schuyler4/LCR_Meter/readme.md

<h3> LCR Meter </h3>
<p>
 This is my attempt at making an LCR meter. It is still in progress, but here is a schematic if you are interested.
</p>
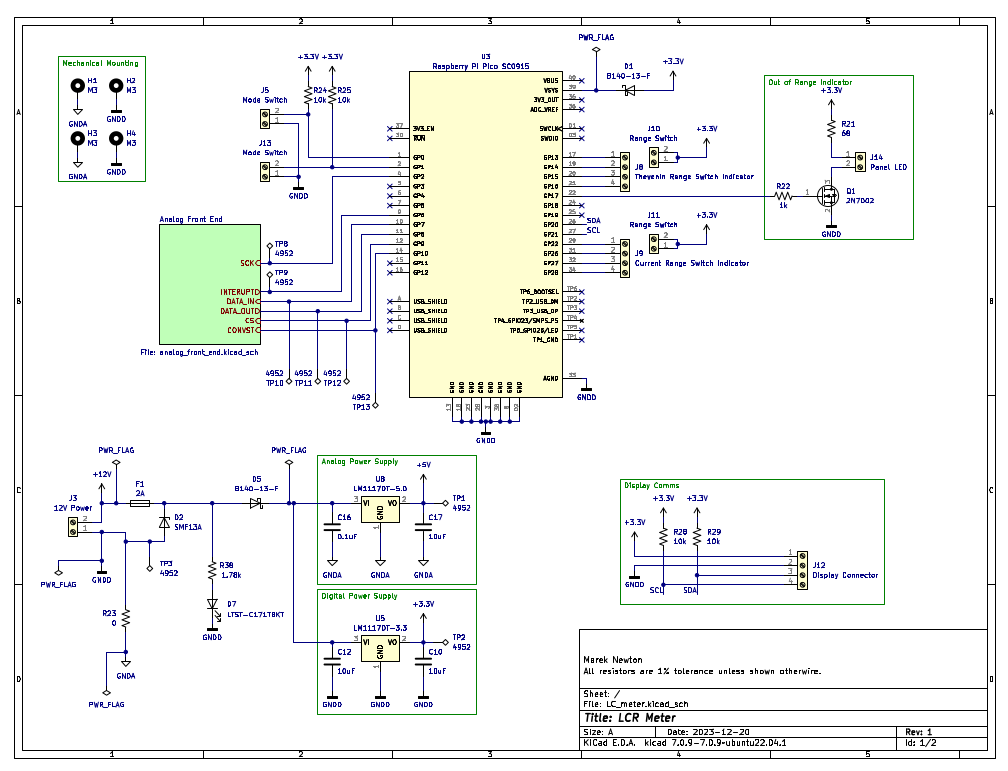
[picture p1: electronics/rev1/outputs/page1_schematic.png]

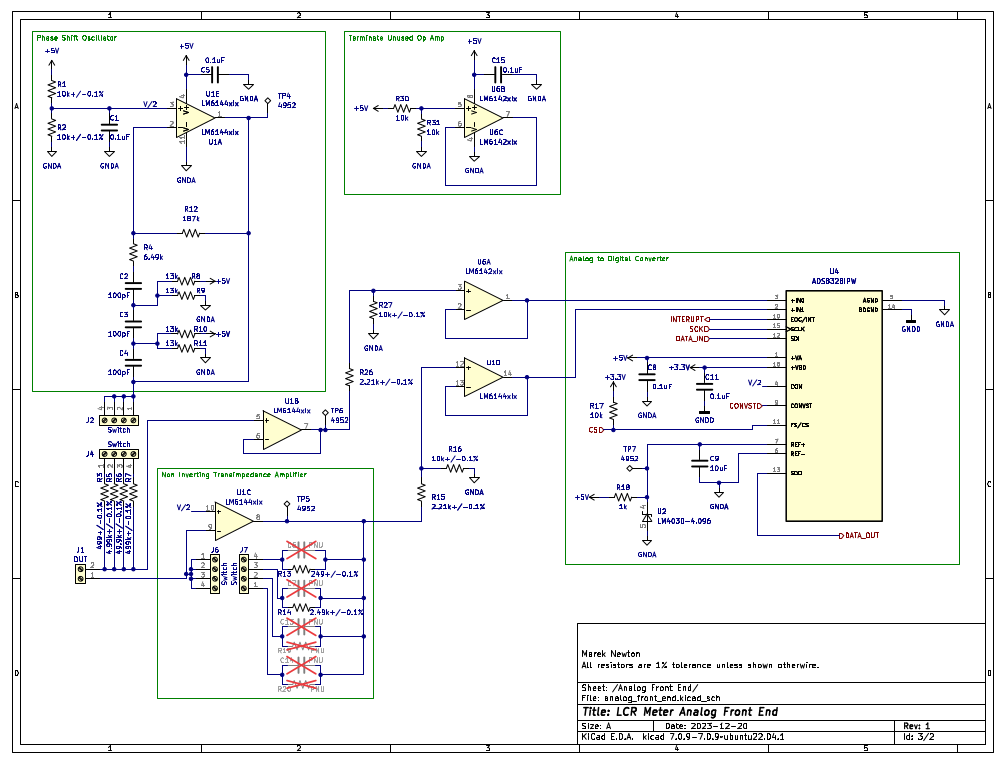
[picture p2: electronics/rev1/outputs/page2_schematic.png]
