schuyler4/LCR_Meter/new_firmware/signal.png

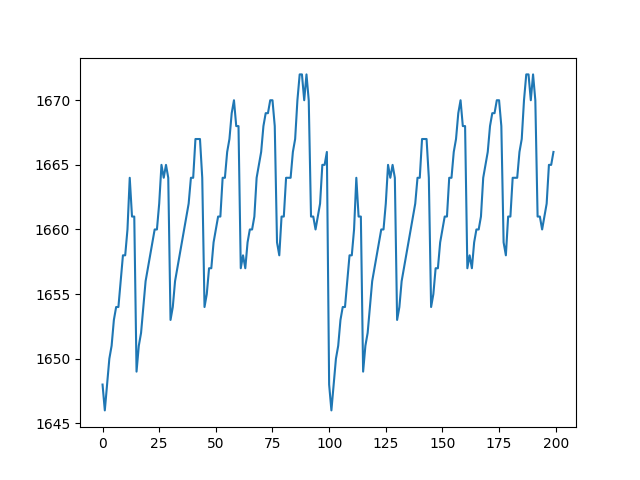
new_firmware/signal.png
