schuyler4/LCR_Meter/electronics/rev2/outputs/LCR_meter.step

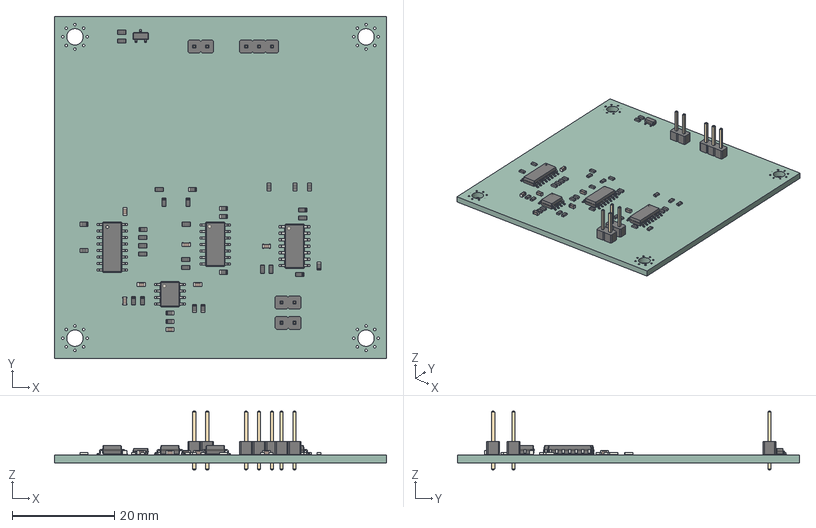
[picture p4: CAD file, 2024-09-23]
electronics/rev2/outputs/LCR_meter.step
65.0 x 67.0 x 11.5 mm
SOIC_8_39x49mm_P127mm
R_0603_1608Metric x 33
SOIC_16_39x99mm_P127mm
C_0603_1608Metric x 7
SOIC_14_39x87mm_P127mm x 2
SOT_23
PinHeader_1x03_P254mm_Vertical
PinHeader_1x02_P254mm_Vertical x 3
LCR_meter_PCB
