schuyler4/LCR_Meter/new_firmware/test.txt

143

134

80

57

95

144

135

80

57

95

144

134

80

57

95

144

134

80

57

95

144

135

80

57

95

144

135

80

57

95

144

135

80

57

95

144

135

80

57

96

144

134

80

57

95

144

135

80

57

95

144

135

81

57

96

144

135

80

57

95

144

135

80

57

95

144

135

81

57

96

144

135

80

57

95

144

135

80

57

95

144

135

80

57

96

144

135

80

57

95

144

135

80

57

96

144

135

81

57

96
