schuyler4/LCR_Meter/electronics/rev2/outputs/LCR_meter_schematic.pdf

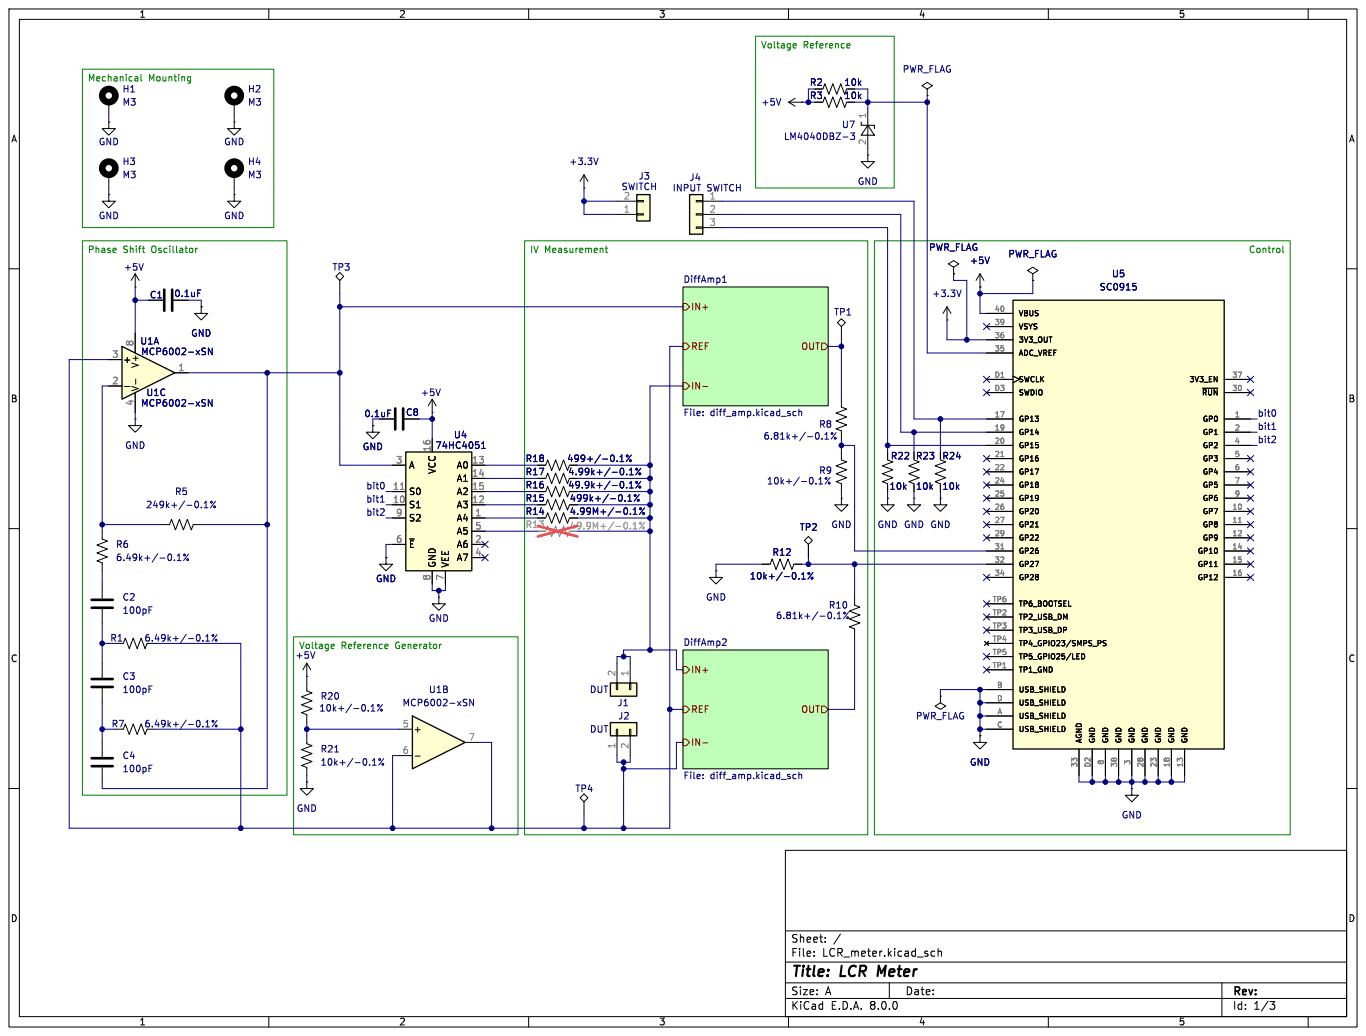
[picture p5: page 1]

IN+ REF DiffAmp2 File: diff_amp.kicad_sch OUT

Id: 1/3 Title: LCR Meter File: LCR_meter.kicad_sch Sheet: / OUT

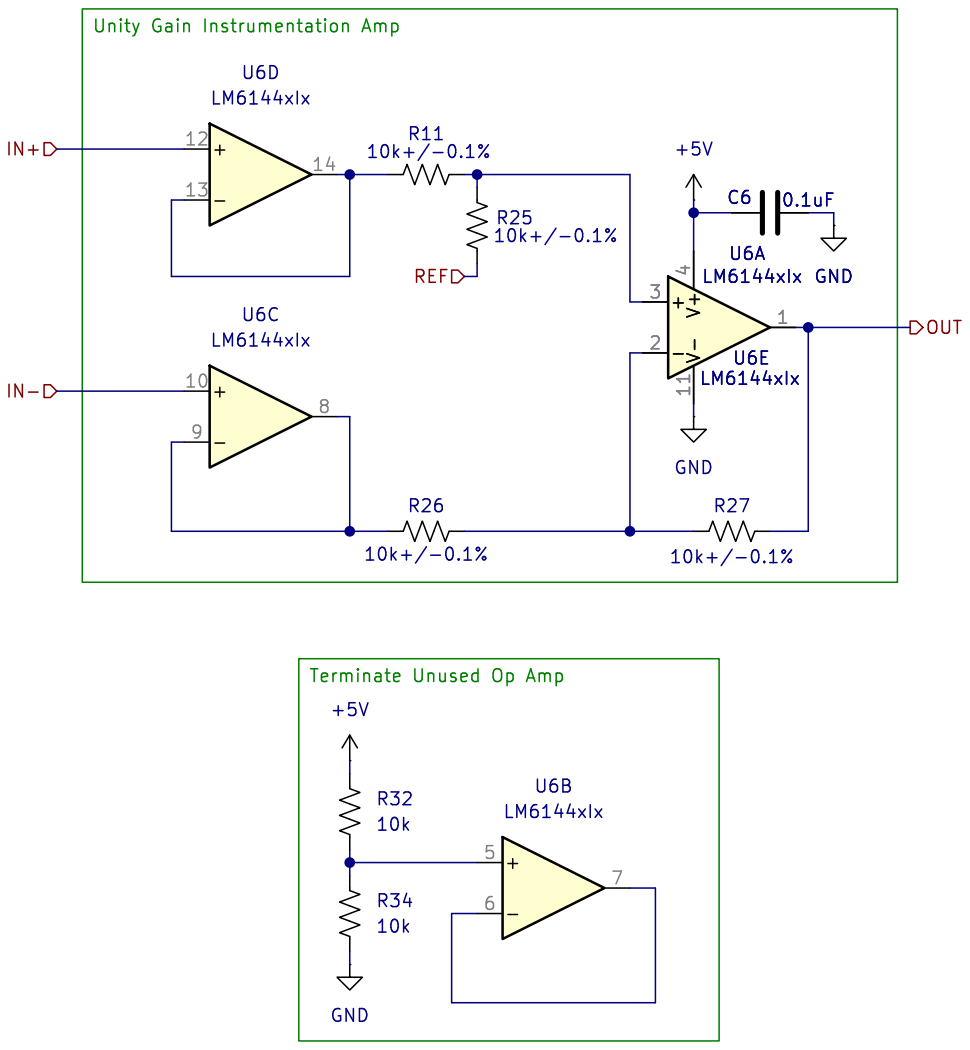
[picture p6: page 2]

File: diff_amp.kicad_sch Sheet: /DiffAmp2/
Id: 2/3 Title: Diff Amp

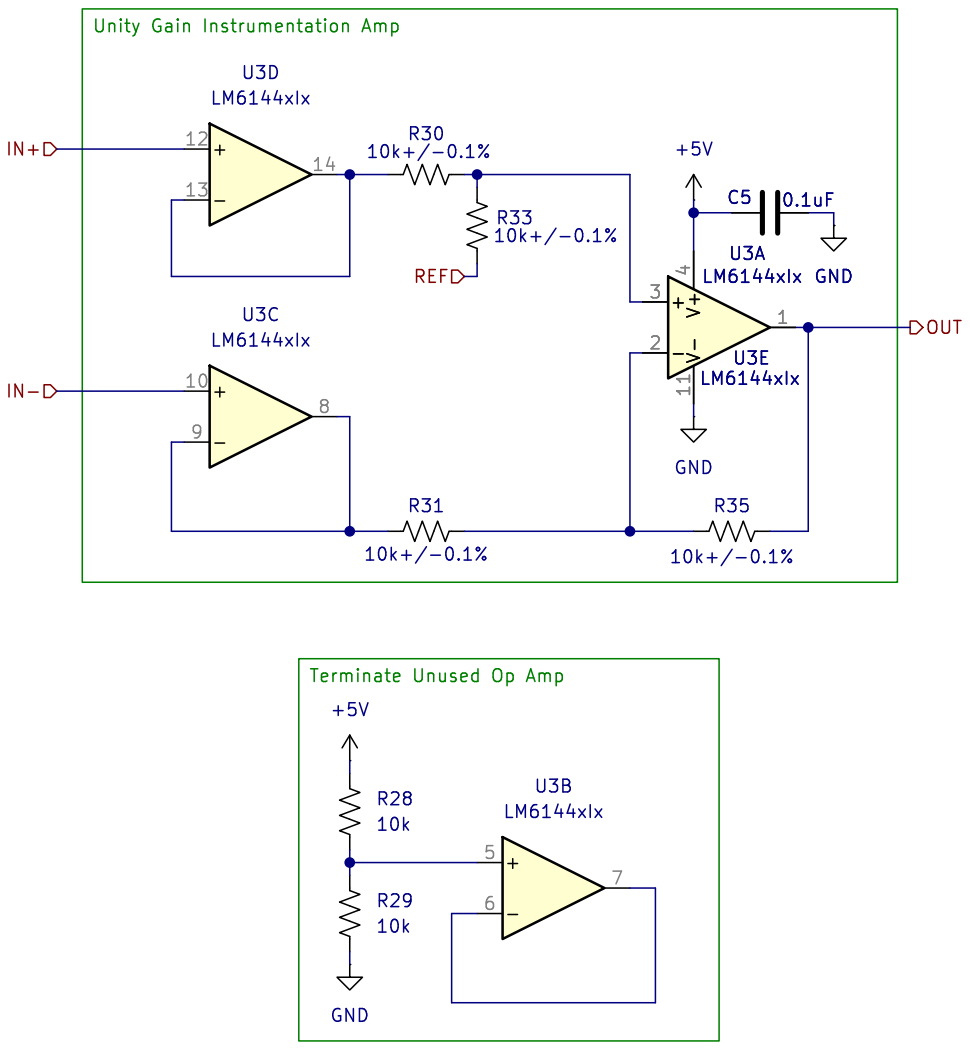
[picture p7: page 3]

File: diff_amp.kicad_sch Sheet: /DiffAmp1/
Id: 3/3 Title: Diff Amp
