schuyler4/LCR_Meter/electronics/rev1/outputs/LC_meter.pdf

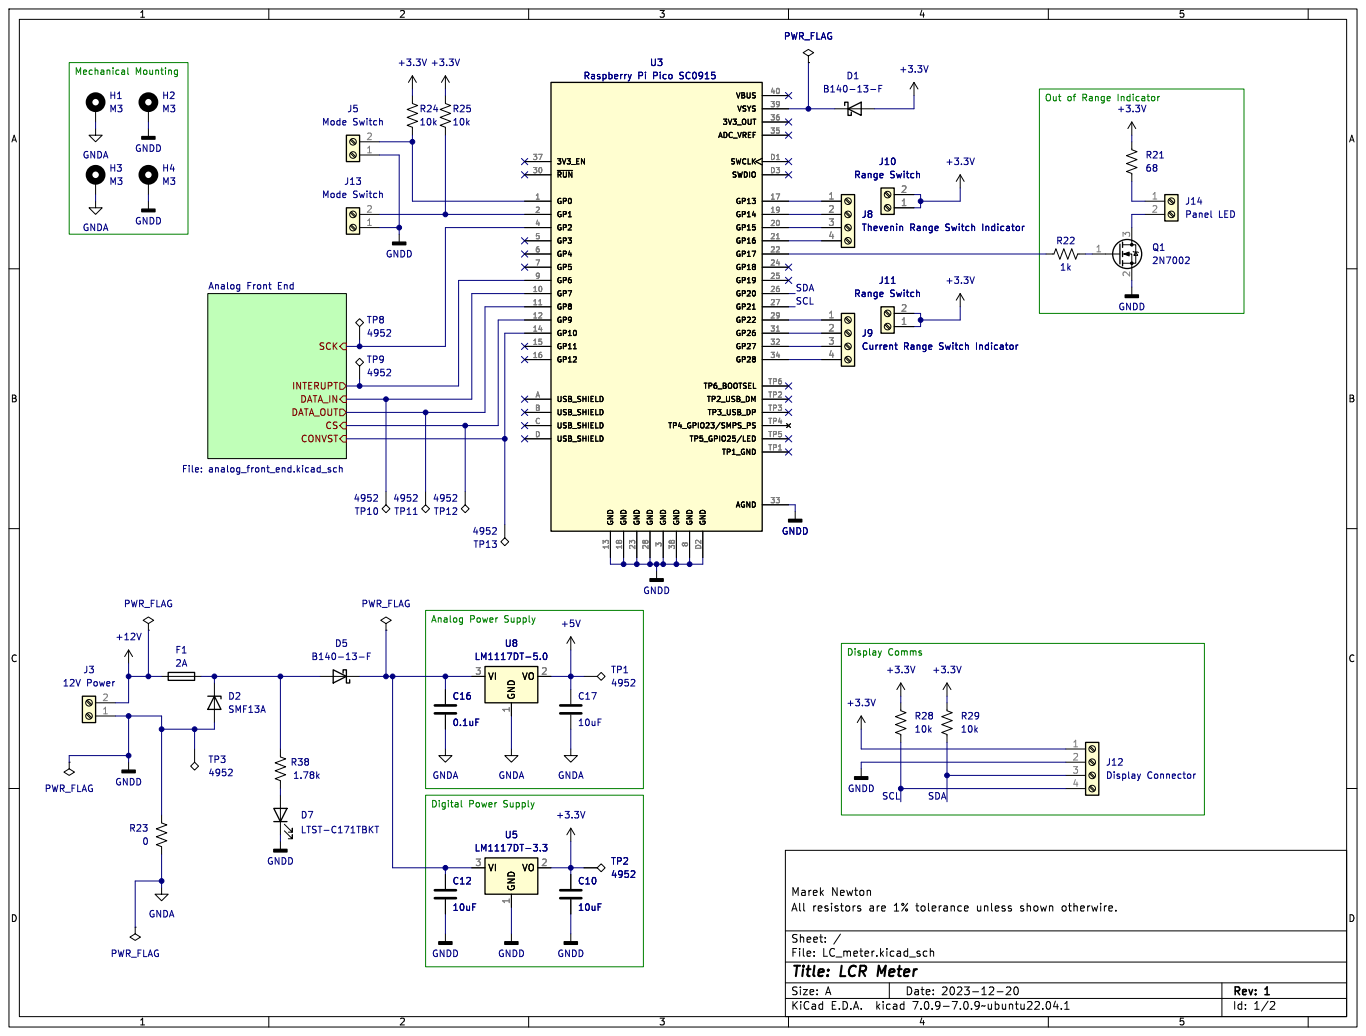
[picture p8: page 1]

Out of Range Indicator Display Comms

DATA_OUT CS CONVST Analog Front End File: analog_front_end.kicad_sch

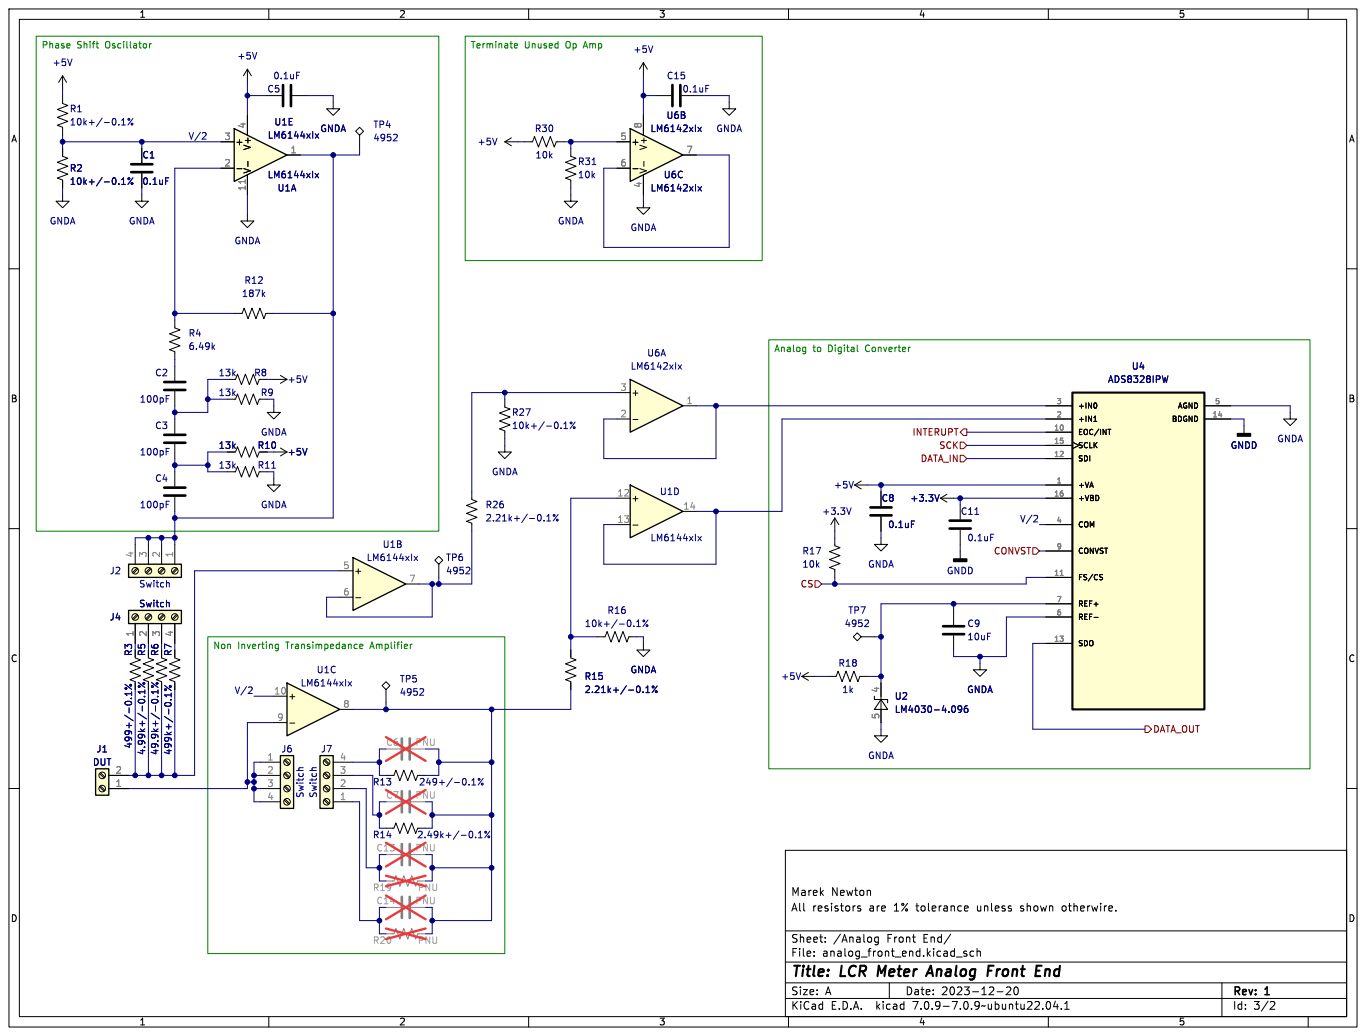
[picture p9: page 2]

Id: 3/2 Title: LCR Meter Analog Front End
