schuyler4/LCR_Meter/electronics/rev2/ecad/LCR_meter.kicad_pcb

## KiCad design electronics/rev2/ecad/LCR_meter.kicad_pcb (2024-09-23)

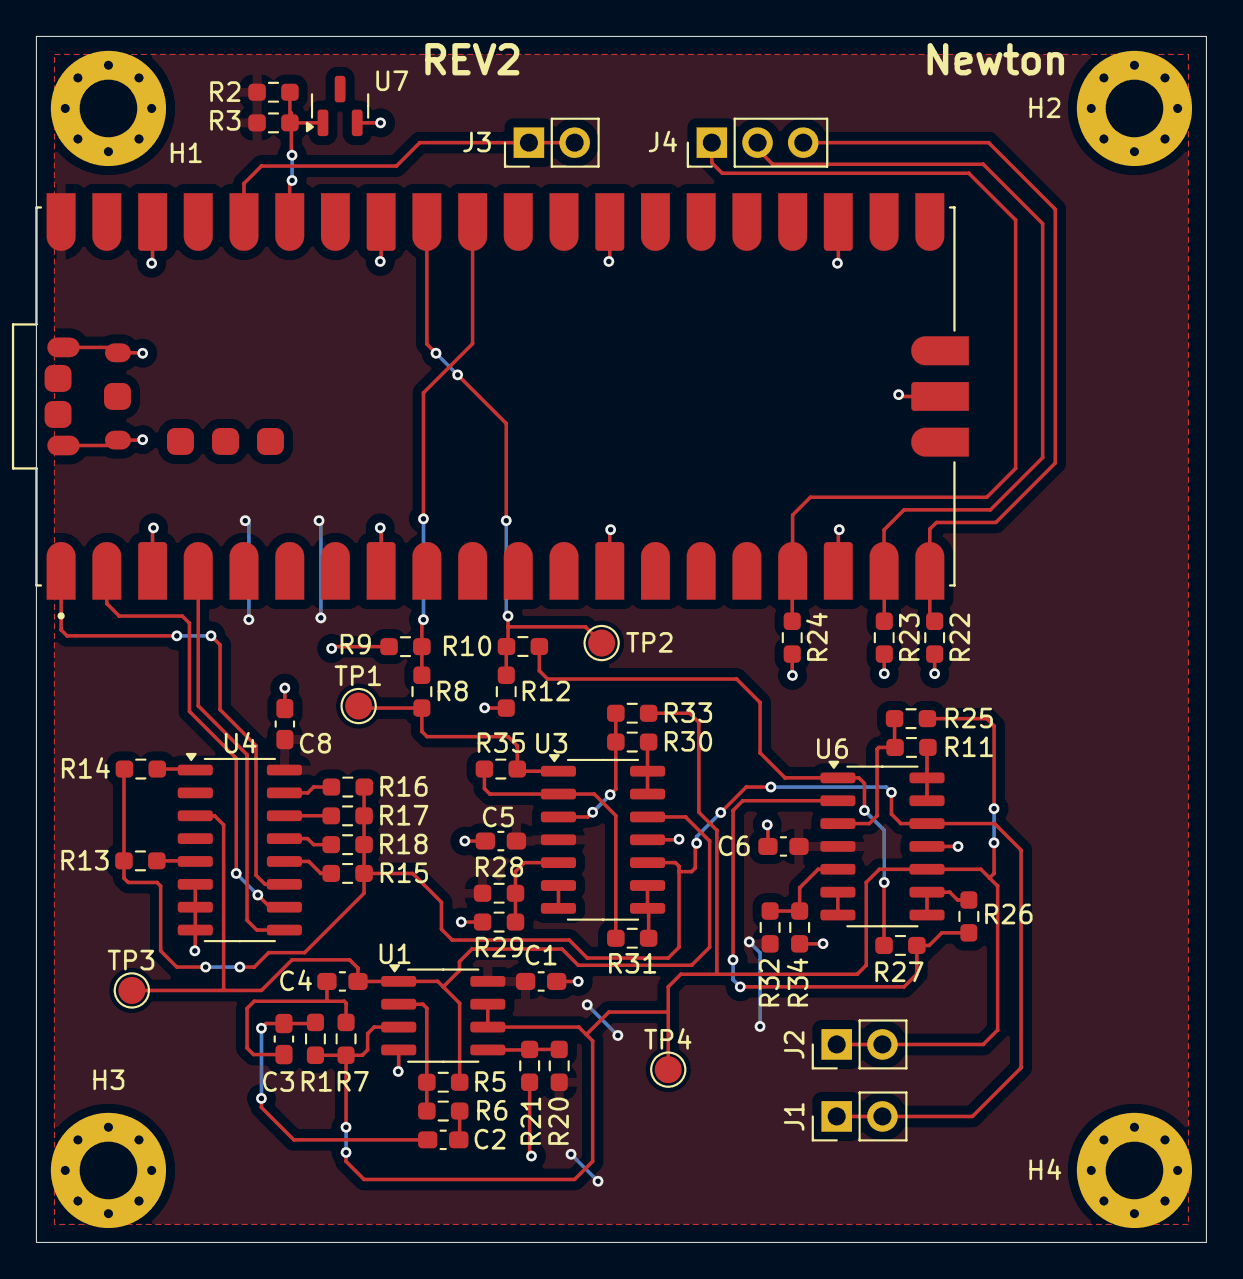
[picture p10: board LCR_meter.kicad_pcb from above]

Board: 2 copper layers, 65.0 x 67.0 mm, 58 parts (0 on the bottom side), 40 nets.

Parts:
C1, C5, C6, C8: 0.1uF; C_0603_1608Metric_Pad1.08x0.95mm_HandSolder
C2, C3, C4: 100pF; C_0603_1608Metric_Pad1.08x0.95mm_HandSolder
H1, H2, H3, H4: M3; MountingHole_3.2mm_M3_Pad_Via
J1, J2: DUT; PinHeader_1x02_P2.54mm_Vertical
J3: SWITCH; PinHeader_1x02_P2.54mm_Vertical
J4: INPUT SWITCH; PinHeader_1x03_P2.54mm_Vertical
R1, R6, R7: 6.49k+/-0.1%; R_0603_1608Metric_Pad0.98x0.95mm_HandSolder
R2, R3, R22, R23, R24, R28, R29, R32, R34: 10k; R_0603_1608Metric_Pad0.98x0.95mm_HandSolder
R5: 249k+/-0.1%; R_0603_1608Metric_Pad0.98x0.95mm_HandSolder
R8, R10: 6.81k+/-0.1%; R_0603_1608Metric_Pad0.98x0.95mm_HandSolder
R9, R11, R12, R20, R21, R25, R26, R27, R30, R31, R33, R35: 10k+/-0.1%; R_0603_1608Metric_Pad0.98x0.95mm_HandSolder
R13: 49.9M+/-0.1%; R_0603_1608Metric_Pad0.98x0.95mm_HandSolder
R14: 4.99M+/-0.1%; R_0603_1608Metric_Pad0.98x0.95mm_HandSolder
R15: 499k+/-0.1%; R_0603_1608Metric_Pad0.98x0.95mm_HandSolder
R16: 49.9k+/-0.1%; R_0603_1608Metric_Pad0.98x0.95mm_HandSolder
R17: 4.99k+/-0.1%; R_0603_1608Metric_Pad0.98x0.95mm_HandSolder
R18: 499+/-0.1%; R_0603_1608Metric_Pad0.98x0.95mm_HandSolder
TP1, TP2, TP3, TP4: TestPoint_Pad_D1.5mm
U1: MCP6002-xSN; SOIC-8_3.9x4.9mm_P1.27mm
U3, U6: LM6144xIx; SOIC-14_3.9x8.7mm_P1.27mm
U4: 74HC4051; SOIC-16_3.9x9.9mm_P1.27mm
U5: SC0915; MODULE_SC0915
U7: LM4040DBZ-3; SOT-23

Connections:
+3.3V: J3.1, J3.2, U5.36 (3V3_OUT)
+5V: C1.1, C5.1, C6.1, C8.2, R2.1, R3.1, R20.1, R28.1, R32.1, U1.8 (V+), U3.4 (V+), U4.16 (VCC), U5.40 (VBUS), U6.4 (V+)
/DiffAmp1/IN+: C4.2, R5.2, TP3.1, U1.1, U3.12 (+), U4.3 (A)
/DiffAmp1/IN-: J1.1, J1.2, R13.2, R14.2, R15.2, R16.2, R17.2, R18.2, U3.10 (+), U6.12 (+)
/DiffAmp1/OUT: R8.2, R35.2, TP1.1, U3.1
/DiffAmp1/REF: J2.1, J2.2, R1.2, R7.2, R25.1, R33.1, TP4.1, U1.3 (+), U1.6 (-), U1.7, U6.10 (+)
/DiffAmp2/OUT: R10.2, R27.2, U6.1
/bit0: U4.11 (S0), U5.1 (GP0)
/bit1: U4.10 (S1), U5.2 (GP1)
/bit2: U4.9 (S2), U5.4 (GP2)
GND: C1.2, C5.2, C6.2, C8.1, H1.1, H2.1, H3.1, H4.1, R9.1, R12.2, R21.2, R22.2, R23.2, R24.2, R29.2, R34.2, U1.4 (V-), U3.11 (V-), U4.6 (~E), U4.7 (VEE), U4.8 (GND), U5.3 (GND), U5.8 (GND), U5.13 (GND), U5.18 (GND), U5.23 (GND), U5.28 (GND), U5.33 (AGND), U5.38 (GND), U5.A (USB_SHIELD), U5.B (USB_SHIELD), U5.C (USB_SHIELD), U5.D (USB_SHIELD), U5.D2 (GND), U6.11 (V-), U7.2 (A)
unnamed: C2.1, R6.2
unnamed: C2.2, C3.1, R1.1
unnamed: C3.2, C4.1, R7.1
unnamed: J4.1, R24.1, U5.17 (GP13)
unnamed: J4.2, R23.1, U5.19 (GP14)
unnamed: J4.3, R22.1, U5.20 (GP15)
unnamed: R5.1, R6.1, U1.2 (-)
unnamed: R20.2, R21.1, U1.5 (+)
unnamed: R30.2, R33.2, U3.3 (+)
unnamed: R31.2, R35.1, U3.2 (-)
unnamed: R28.2, R29.1, U3.5 (+)
unnamed: U3.6 (-), U3.7
unnamed: R31.1, U3.8, U3.9 (-)
unnamed: R30.1, U3.13 (-), U3.14
unnamed: R18.1, U4.13 (A0)
unnamed: R17.1, U4.14 (A1)
unnamed: R16.1, U4.15 (A2)
unnamed: R15.1, U4.12 (A3)
unnamed: R14.1, U4.1 (A4)
unnamed: R13.1, U4.5 (A5)
unnamed: R2.2, R3.2, U5.35 (ADC_VREF), U7.1 (K)
unnamed: R8.1, R9.2, U5.31 (GP26)
unnamed: R10.1, R12.1, TP2.1, U5.32 (GP27)
unnamed: R11.2, R25.2, U6.3 (+)
unnamed: R26.2, R27.1, U6.2 (-)
unnamed: R32.2, R34.1, U6.5 (+)
unnamed: U6.6 (-), U6.7
unnamed: R26.1, U6.8, U6.9 (-)
unnamed: R11.1, U6.13 (-), U6.14
