schuyler4/LCR_Meter/electronics/rev1/ecad/LC_meter.kicad_pcb

## KiCad design electronics/rev1/ecad/LC_meter.kicad_pcb (2023-12-28, an earlier design)

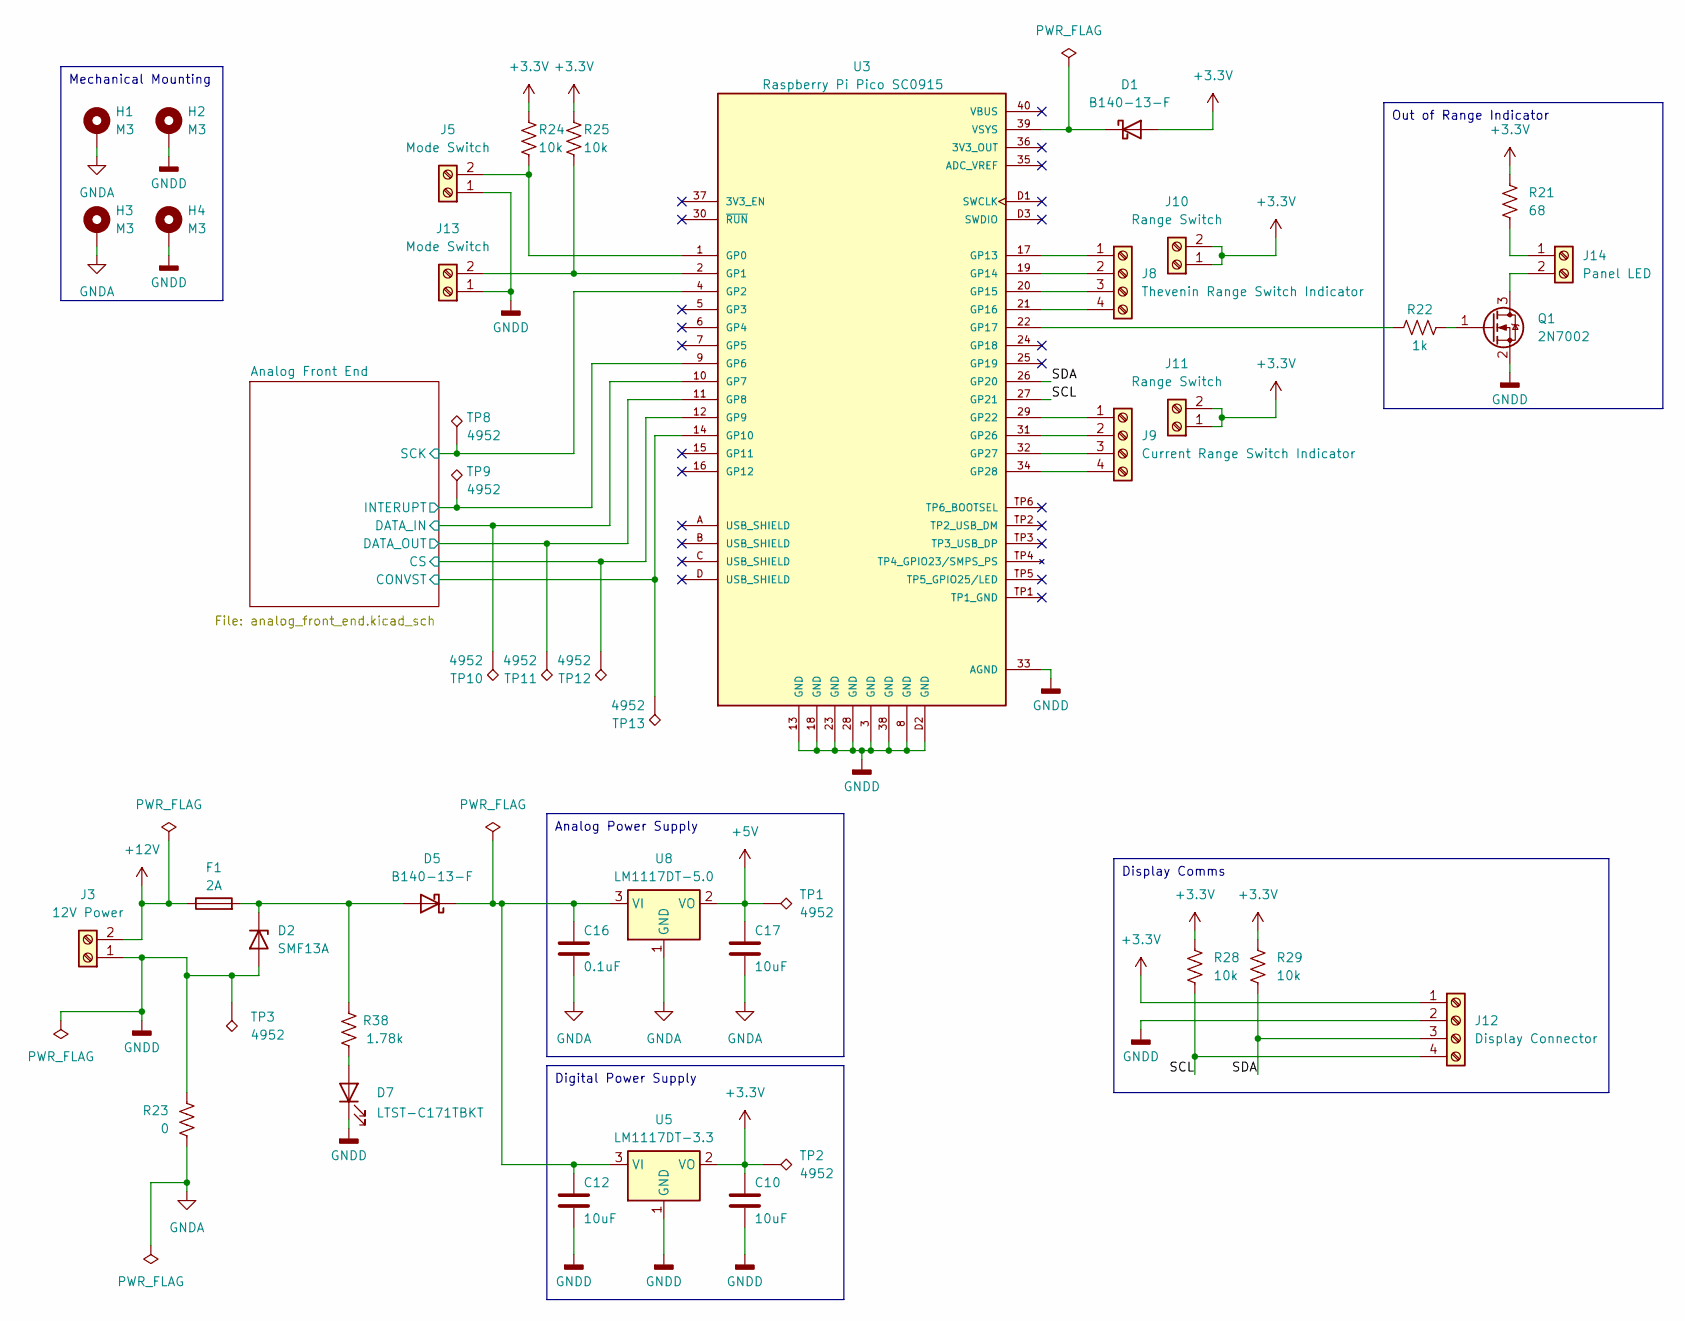
[picture p11: schematic LC_meter.kicad_sch, LCR Meter]

Parts:
C10, C12, C17: 10uF; C_0805_2012Metric; Part # CL21A106KOQNNNE
C16: 0.1uF; C_0805_2012Metric; Part # CL21B104KBCNNNC
D1, D5: B140-13-F; D_SMA; Part # B140-13-F
D2: SMF13A; D_SOD-123F; Part # SMF13A-TP
D7: LTST-C171TBKT; LED_0805_2012Metric; Part # LTST-C171TBKT
F1: 2A; Fuse_0805_2012Metric; Part # 0685T2000-01
H1, H2, H3, H4: M3; MountingHole_3.2mm_M3_Pad_Via; Part # N/A
J3: 12V Power; TerminalBlock_Phoenix_MPT-0,5-2-2.54_1x02_P2.54mm_Horizontal; Part # OSTVN02A150
J5, J13: Mode Switch; TerminalBlock_Phoenix_MPT-0,5-2-2.54_1x02_P2.54mm_Horizontal; Part # OSTVN02A150
J8: Thevenin Range Switch Indicator; TerminalBlock_Phoenix_MPT-0,5-4-2.54_1x04_P2.54mm_Horizontal; Part # OSTVN04A150
J9: Current Range Switch Indicator; TerminalBlock_Phoenix_MPT-0,5-4-2.54_1x04_P2.54mm_Horizontal; Part # OSTVN04A150
J10, J11: Range Switch; TerminalBlock_Phoenix_MPT-0,5-2-2.54_1x02_P2.54mm_Horizontal; Part # OSTVN02A150
J12: Display Connector; TerminalBlock_Phoenix_MPT-0,5-4-2.54_1x04_P2.54mm_Horizontal; Part # OSTVN04A150
J14: Panel LED; TerminalBlock_Phoenix_MPT-0,5-2-2.54_1x02_P2.54mm_Horizontal; Part # OSTVN02A150
Q1: 2N7002; SOT-23; Part # 2N7002
R21: 68; R_0805_2012Metric; Part # ERA-6AEB680V
R22: 1k; R_0805_2012Metric; Part # RMCF0805FT1K00
R23: 0; R_0805_2012Metric; Part # RMCF0805ZT0R00
R24, R25, R28, R29: 10k; R_0805_2012Metric; Part # RMCF0805FT10K0
R38: 1.78k; R_0805_2012Metric; Part # RT0805BRD071K78L
TP1, TP2, TP3, TP8, TP9, TP10, TP11, TP12, TP13: 4952; Pin_D1.2mm_L10.2mm_W2.9mm_FlatFork; Part # 4952
U3: Raspberry Pi Pico SC0915; MODULE_SC0915; Part # SC0915
U5: LM1117DT-3.3; TO-252-3_TabPin2; Part # LM1117DT-3.3/NOPB
U8: LM1117DT-5.0; TO-252-3_TabPin2; Part # LM1117DT-5.0/NOPB

Connections:
+3.3V: C10.1, D1.2 (A), J10.1, J10.2, J11.1, J11.2, J12.1, R21.1, R24.1, R25.1, R28.1, R29.1, TP2.1, U5.2 (VO); also elsewhere on the board
+5V: C17.1, TP1.1, U8.2 (VO); also elsewhere on the board
+12V: F1.1, J3.2
/Analog Front End/CONVST: TP13.1, U3.14 (GP10); also elsewhere on the board
/Analog Front End/CS: TP12.1, U3.12 (GP9); also elsewhere on the board
/Analog Front End/DATA_IN: TP10.1, U3.10 (GP7); also elsewhere on the board
/Analog Front End/DATA_OUT: TP11.1, U3.11 (GP8); also elsewhere on the board
/Analog Front End/INTERUPT: TP9.1, U3.9 (GP6); also elsewhere on the board
/Analog Front End/SCK: TP8.1, U3.4 (GP2); also elsewhere on the board
/SCL: J12.4, R28.2, U3.27 (GP21)
/SDA: J12.3, R29.2, U3.26 (GP20)
GNDA: C16.2, C17.2, H1.1, H3.1, R23.2, U8.1 (GND); also elsewhere on the board
GNDD: C10.2, C12.2, D2.2 (A), D7.1 (K), H2.1, H4.1, J3.1, J5.1, J12.2, J13.1, Q1.2 (S), R23.1, TP3.1, U3.3 (GND), U3.8 (GND), U3.13 (GND), U3.18 (GND), U3.23 (GND), U3.28 (GND), U3.33 (AGND), U3.38 (GND), U3.D2 (GND), U5.1 (GND); also elsewhere on the board
unnamed: D1.1 (K), U3.39 (VSYS)
unnamed: D2.1 (K), D5.2 (A), F1.2, R38.2
unnamed: C12.1, C16.1, D5.1 (K), U5.3 (VI), U8.3 (VI)
unnamed: D7.2 (A), R38.1
unnamed: J5.2, R24.2, U3.1 (GP0)
unnamed: J8.1, U3.17 (GP13)
unnamed: J8.2, U3.19 (GP14)
unnamed: J8.3, U3.20 (GP15)
unnamed: J8.4, U3.21 (GP16)
unnamed: J9.1, U3.29 (GP22)
unnamed: J9.2, U3.31 (GP26)
unnamed: J9.3, U3.32 (GP27)
unnamed: J9.4, U3.34 (GP28)
unnamed: J13.2, R25.2, U3.2 (GP1)
unnamed: J14.1, R21.2
unnamed: J14.2, Q1.3 (D)
unnamed: Q1.1 (G), R22.2
unnamed: R22.1, U3.22 (GP17)

Notes on the sheet:
Analog Power Supply
Out of Range Indicator
Display Comms
Digital Power Supply
Mechanical Mounting

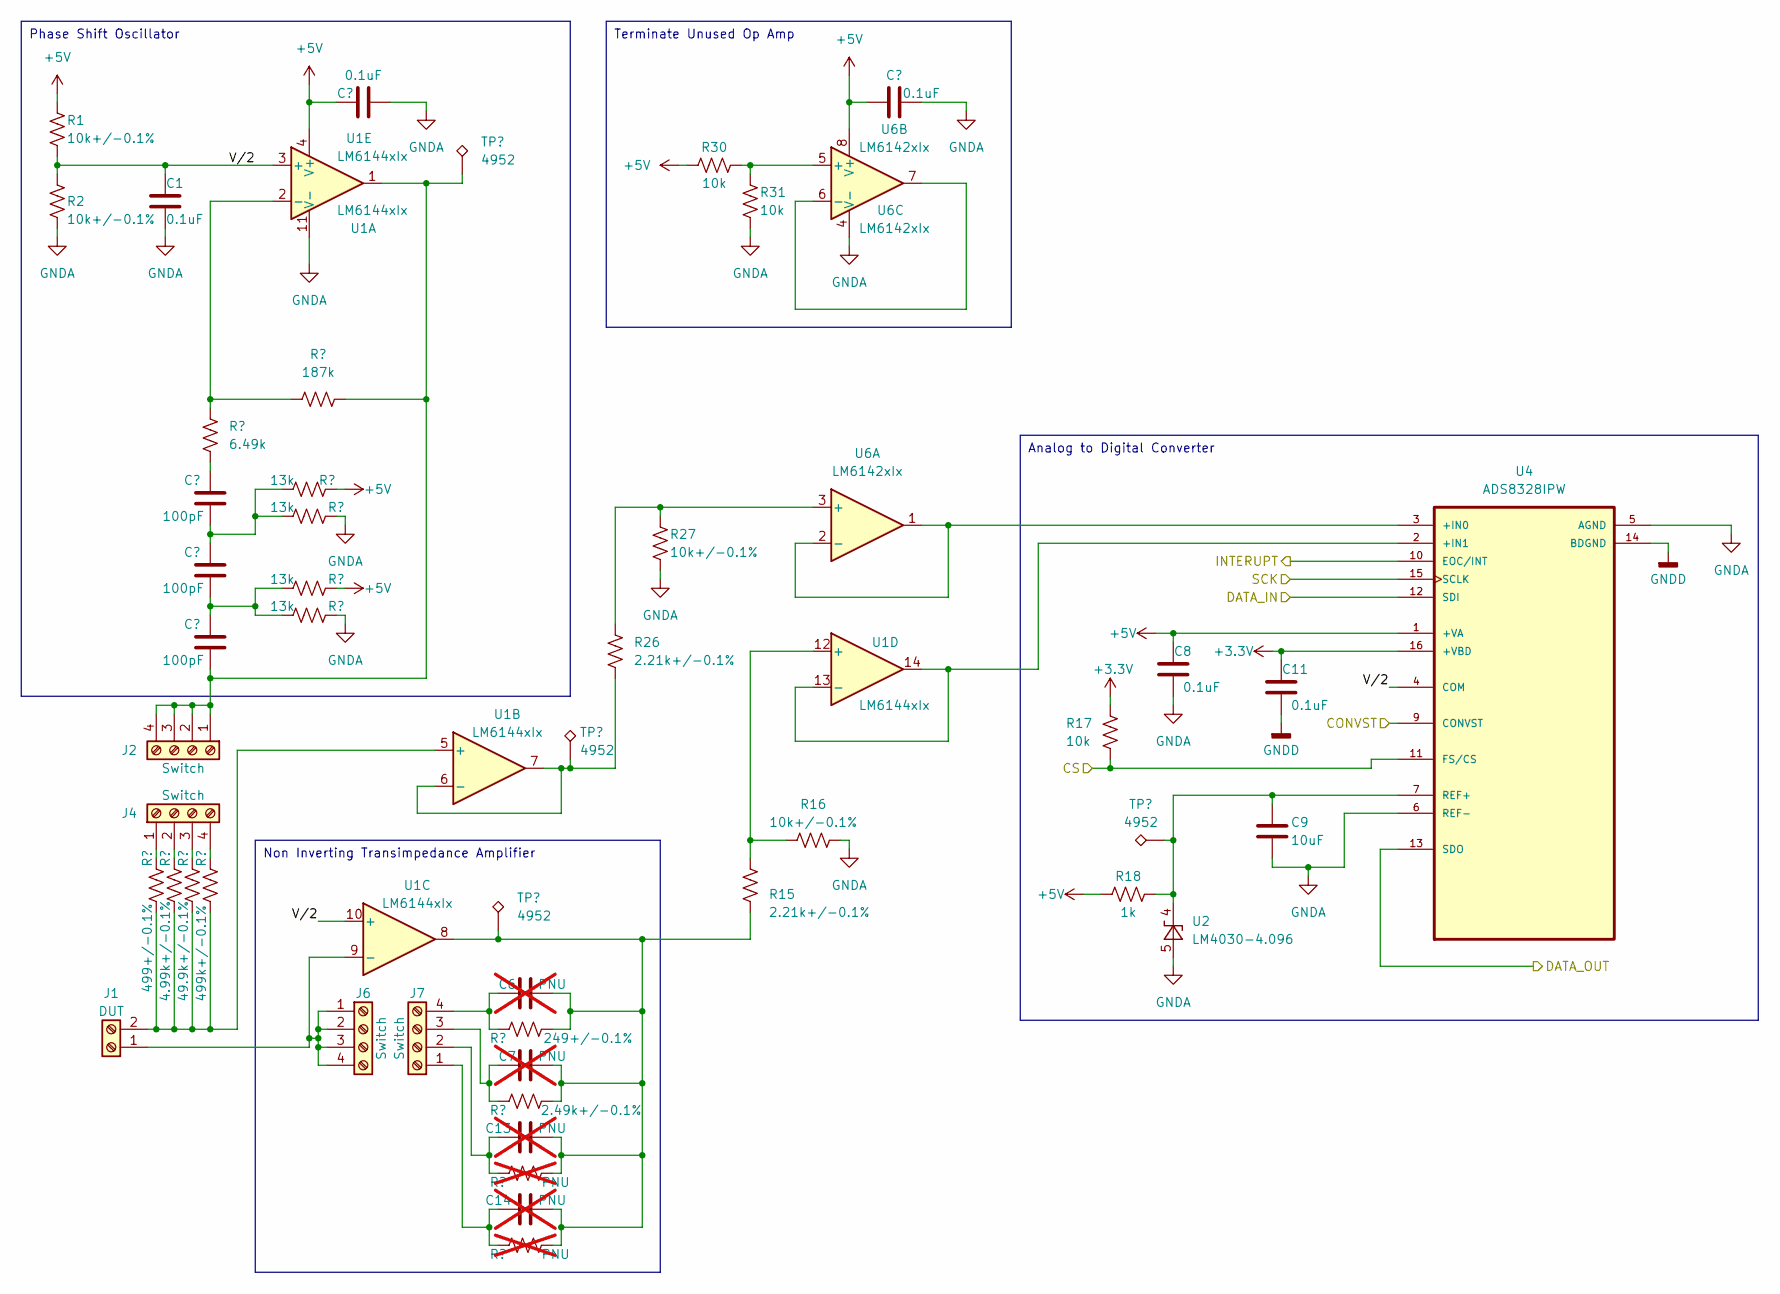
[picture p12: schematic analog_front_end.kicad_sch, LCR Meter Analog Front End]

Parts:
C1, C5, C8, C11, C15: 0.1uF; C_0805_2012Metric; Part # CL21B104KBCNNNC
C2, C3, C4: 100pF; C_0805_2012Metric; Part # CL21C101JCANNNC
C6, C7, C13, C14: PNU; C_0805_2012Metric; Part # N/A; not fitted
C9: 10uF; C_0805_2012Metric; Part # CL21A106KOQNNNE
J1: DUT; TerminalBlock_Phoenix_MPT-0,5-2-2.54_1x02_P2.54mm_Horizontal; Part # OSTVN02A150
J2, J4, J6, J7: Switch; TerminalBlock_Phoenix_MPT-0,5-4-2.54_1x04_P2.54mm_Horizontal; Part # OSTVN04A150
R1, R2, R16, R27: 10k+/-0.1%; R_0805_2012Metric; Part # ERA-6AEB103V
R3: 499+/-0.1%; R_0805_2012Metric; Part # RG2012P-4990-B-T5
R4: 6.49k; R_0805_2012Metric; Part # RMCF0805FT6K49
R5: 4.99k+/-0.1%; R_0805_2012Metric; Part # ERA-6AEB4991V
R6: 49.9k+/-0.1%; R_0805_2012Metric; Part # ERA-6AEB4992V
R7: 499k+/-0.1%; R_0805_2012Metric; Part # RG2012P-4993-B-T5
R8, R9, R10, R11: 13k; R_0805_2012Metric; Part # RMCF0805FT13K0
R12: 187k; R_0805_2012Metric; Part # RMCF0805FT187K
R13: 249+/-0.1%; R_0805_2012Metric; Part # ERJ-PB6B2490V
R14: 2.49k+/-0.1%; R_0805_2012Metric; Part # RP0805BRD072K49L
R15, R26: 2.21k+/-0.1%; R_0805_2012Metric; Part # ERA-6AEB2211V
R17, R30, R31: 10k; R_0805_2012Metric; Part # RMCF0805FT10K0
R18: 1k; R_0805_2012Metric; Part # RMCF0805FT1K00
R19, R20: PNU; R_0805_2012Metric; Part # N/A; not fitted
TP4, TP5, TP6, TP7: 4952; Pin_D1.2mm_L10.2mm_W2.9mm_FlatFork; Part # 4952
U1: LM6144xIx; DIP-14_W7.62mm; Part # LM6144BIN/NOPB
U2: LM4030-4.096; SOT-23-5; Part # LM4030CMF-4.096/NOPB
U4: ADS8328IPW; TSSOP-16_4.4x5mm_P0.65mm; Part # ADS8328IPW
U6: LM6142xIx; DIP-8_W7.62mm; Part # LM6142BIN/NOPB

Connections:
+3.3V: C11.1, R17.1, U4.16 (+VBD); also elsewhere on the board
+5V: C5.1, C8.1, C15.1, R1.1, R8.2, R10.2, R18.1, R30.1, U1.4 (V+), U4.1 (+VA), U6.8 (V+); also elsewhere on the board
/Analog Front End/CONVST: U4.9 (CONVST); also elsewhere on the board
/Analog Front End/CS: R17.2, U4.11 (FS/CS); also elsewhere on the board
/Analog Front End/DATA_IN: U4.12 (SDI); also elsewhere on the board
/Analog Front End/DATA_OUT: U4.13 (SDO); also elsewhere on the board
/Analog Front End/INTERUPT: U4.10 (EOC/INT); also elsewhere on the board
/Analog Front End/SCK: U4.15 (SCLK); also elsewhere on the board
/Analog Front End/V/2: C1.1, R1.2, R2.1, U1.3 (+), U1.10 (+), U4.4 (COM)
GNDA: C1.2, C5.2, C8.2, C9.2, C15.2, R2.2, R9.2, R11.2, R16.2, R27.2, R31.1, U1.11 (V-), U2.5 (A), U4.5 (AGND), U4.6 (REF-), U6.4 (V-); also elsewhere on the board
GNDD: C11.2, U4.14 (BDGND); also elsewhere on the board
unnamed: C2.1, C3.2, R8.1, R9.1
unnamed: C2.2, R4.1
unnamed: C3.1, C4.2, R10.1, R11.1
unnamed: C6.2, C7.2, C13.2, C14.2, R13.2, R14.2, R15.2, R19.2, R20.2, TP5.1, U1.8
unnamed: J1.1, J6.1, J6.2, J6.3, J6.4, U1.9 (-)
unnamed: J1.2, R3.2, R5.2, R6.2, R7.2, U1.5 (+)
unnamed: C4.1, J2.1, J2.2, J2.3, J2.4, R12.2, TP4.1, U1.1
unnamed: J4.1, R3.1
unnamed: J4.2, R5.1
unnamed: J4.3, R6.1
unnamed: J4.4, R7.1
unnamed: C14.1, J7.1, R20.1
unnamed: C13.1, J7.2, R19.1
unnamed: C7.1, J7.3, R14.1
unnamed: C6.1, J7.4, R13.1
unnamed: R4.2, R12.1, U1.2 (-)
unnamed: R26.2, TP6.1, U1.6 (-), U1.7
unnamed: R15.1, R16.1, U1.12 (+)
unnamed: U1.13 (-), U1.14, U4.2 (+IN1)
unnamed: C9.1, R18.2, TP7.1, U2.4 (K), U4.7 (REF+)
unnamed: U4.3 (+IN0), U6.1, U6.2 (-)
unnamed: R26.1, R27.1, U6.3 (+)
unnamed: R30.2, R31.2, U6.5 (+)
unnamed: U6.6 (-), U6.7

Notes on the sheet:
Phase Shift Oscillator
Non Inverting Transimpedance Amplifier
Terminate Unused Op Amp
Analog to Digital Converter

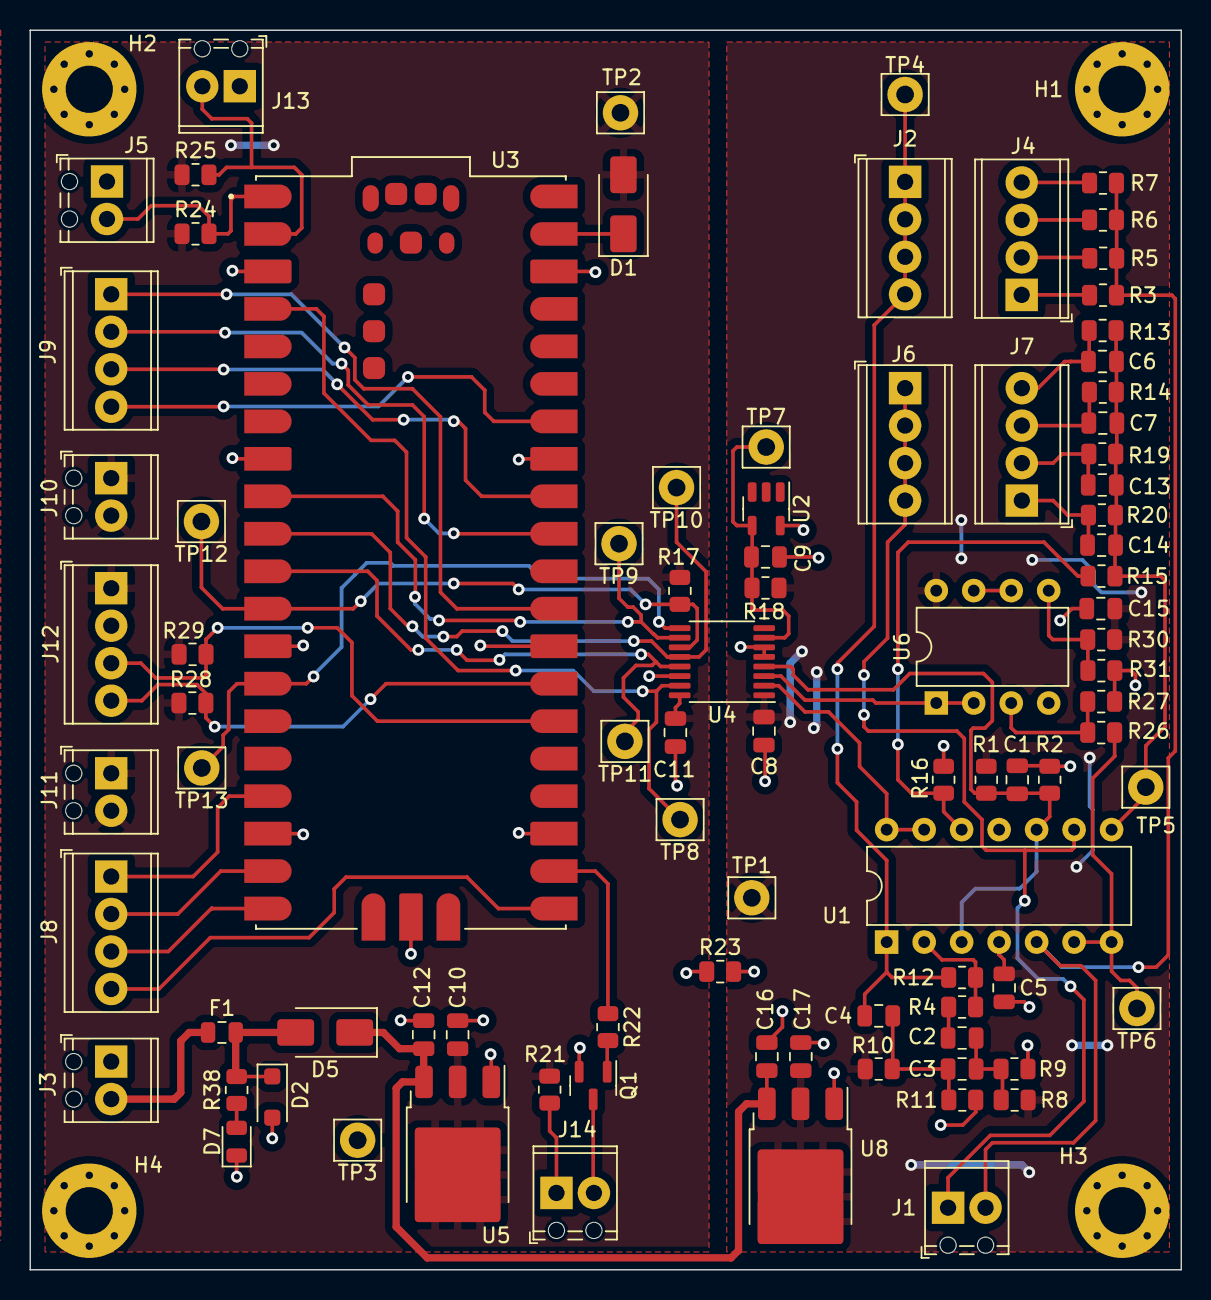
[picture p13: board LC_meter.kicad_pcb from above]

Board: 2 copper layers, 78.0 x 84.0 mm, 93 parts (0 on the bottom side), 56 nets.
