schuyler4/LCR_Meter/firmware/codes.c

int VOLTAGE_CODES[] = {32677, 32720, 32812, 32841, 32761, 32691, 32726, 32819, 32837, 32756, 32689, 32731, 32822, 32835, 32751, 32688, 32735, 32825, 32832, 32746, 32688, 32739, 32828, 32830, 32741, 32688, 32743, 32831, 32826, 32737, 32688, 32748, 32833, 32823, 32732, 32688, 32753, 32835, 32819, 32728, 32689, 32758, 32837, 32816, 32723, 32690, 32762, 32839, 32811, 32721};
int CURRENT_CODES[] = {32756, 31460, 31333, 33421, 34473, 33171, 31232, 31499, 33511, 34497, 33016, 31199, 31554, 33622, 34462, 32925, 31143, 31644, 33703, 34445, 32812, 31111, 31722, 33795, 34410, 32708, 31078, 31812, 33880, 34371, 32600, 31050, 31909, 33958, 34330, 32485, 31037, 31998, 34044, 34268, 32390, 31010, 32115, 34097, 34233, 32256, 31038, 32174, 34225, 34067};
