schuyler4/LCR_Meter/(commit log)

2023-11-18 new computer
    [LC_meter.kicad_sch, analog_front_end.kicad_sch]
2023-11-21 schematic work
    [LC_meter.kicad_sch, analog_front_end.kicad_sch, peak_voltages.sch]
2023-11-24 switch to time based
    [LC_meter.kicad_sch, analog_front_end.kicad_sch, time_analog_front_end.kicad_sch]
2023-11-28 time stuff
    [LC_meter.kicad_pcb, LC_meter.kicad_sch, time_analog_front_end.kicad_sch]
2023-12-03 auto balancing
    [LC_meter.kicad_sch, acquisition.kicad_sch, analog_front_end.kicad_sch, sensing.kicad_sch]
2023-12-08 ok range calcs and schematic
    [LC_meter.kicad_sch, acquisition.kicad_sch, analog_front_end.kicad_sch, aquisitionkicad_sch.kicad_sch]
2023-12-12 fished crash
    [LC_meter.kicad_pcb, LC_meter.kicad_sch, acquisition.kicad_sch, analog_front_end.kicad_sch, aquisitionkicad_sch.kicad_sch, sensing.kicad_sch]
2023-12-14 more layout
    [LC_meter.kicad_pcb, analog_front_end.kicad_sch]
2023-12-16 general work
    [BOM.csv, LC_meter.kicad_pcb, LC_meter.kicad_sch, analog_front_end.kicad_sch]
2023-12-19 layout draft
    [LC_meter.kicad_pcb, LC_meter.kicad_sch, analog_front_end.kicad_sch]
2023-12-20 more work on algorithm
    [LC_meter.kicad_sch, analog_front_end.kicad_sch]
2023-12-21 finished algorithm
    [LC_meter.kicad_pcb, LC_meter.kicad_sch, analog_front_end.kicad_sch]
2023-12-28 firmware talking
    [LC_meter-B_Cu.gbr, LC_meter-B_Mask.gbr, LC_meter-B_Paste.gbr, LC_meter-B_Silkscreen.gbr, LC_meter-Edge_Cuts.gbr, LC_meter-F_Cu.gbr, LC_meter-F_Mask.gbr, LC_meter-F_Paste.gbr]
2023-12-29 ADC Driver Work
2024-01-02 BOM update
    [BOM.csv]
2024-01-02 firmware and BOM
2024-01-03 display driver
2024-01-21 ordered parts
    [BOM.csv]
2024-02-08 spi stuff
2024-02-09 more spi stuff
2024-05-13 peak detector work
    [peak_detector.kicad_pcb, peak_detector.kicad_sch]
2024-09-07 varius work
    [ADC.kicad_pcb, ADC.kicad_sch, peak_detector.kicad_pcb, peak_detector.kicad_sch]
2024-09-08 started rev2 compatible with voltpeek
2024-09-10 rev2 work
    [ADC.kicad_sch, BOM.csv, LCR_meter.kicad_pcb, LCR_meter.kicad_sch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]
2024-09-10 schematic is back
2024-09-17 schematic rev2 might be done
    [LCR_meter.kicad_pcb, LCR_meter.kicad_sch, diff_amp.kicad_sch]
2024-09-23 rev2 design work
    [LCR_meter-B_Cu.gbl, LCR_meter-B_Mask.gbs, LCR_meter-B_Silkscreen.gbo, LCR_meter-Edge_Cuts.gm1, LCR_meter-F_Cu.gtl, LCR_meter-F_Mask.gts, LCR_meter-F_Silkscreen.gto, LCR_meter.drl]
2024-10-13 reading impedances
    [BOM.csv]
2024-10-16 stray capacitance problem
